kstken0210/ESP_Drone/esp32_drone_controller/esp32_drone_controller.kicad_pcb

## KiCad design esp32_drone_controller/esp32_drone_controller.kicad_pcb (2026-10-31)

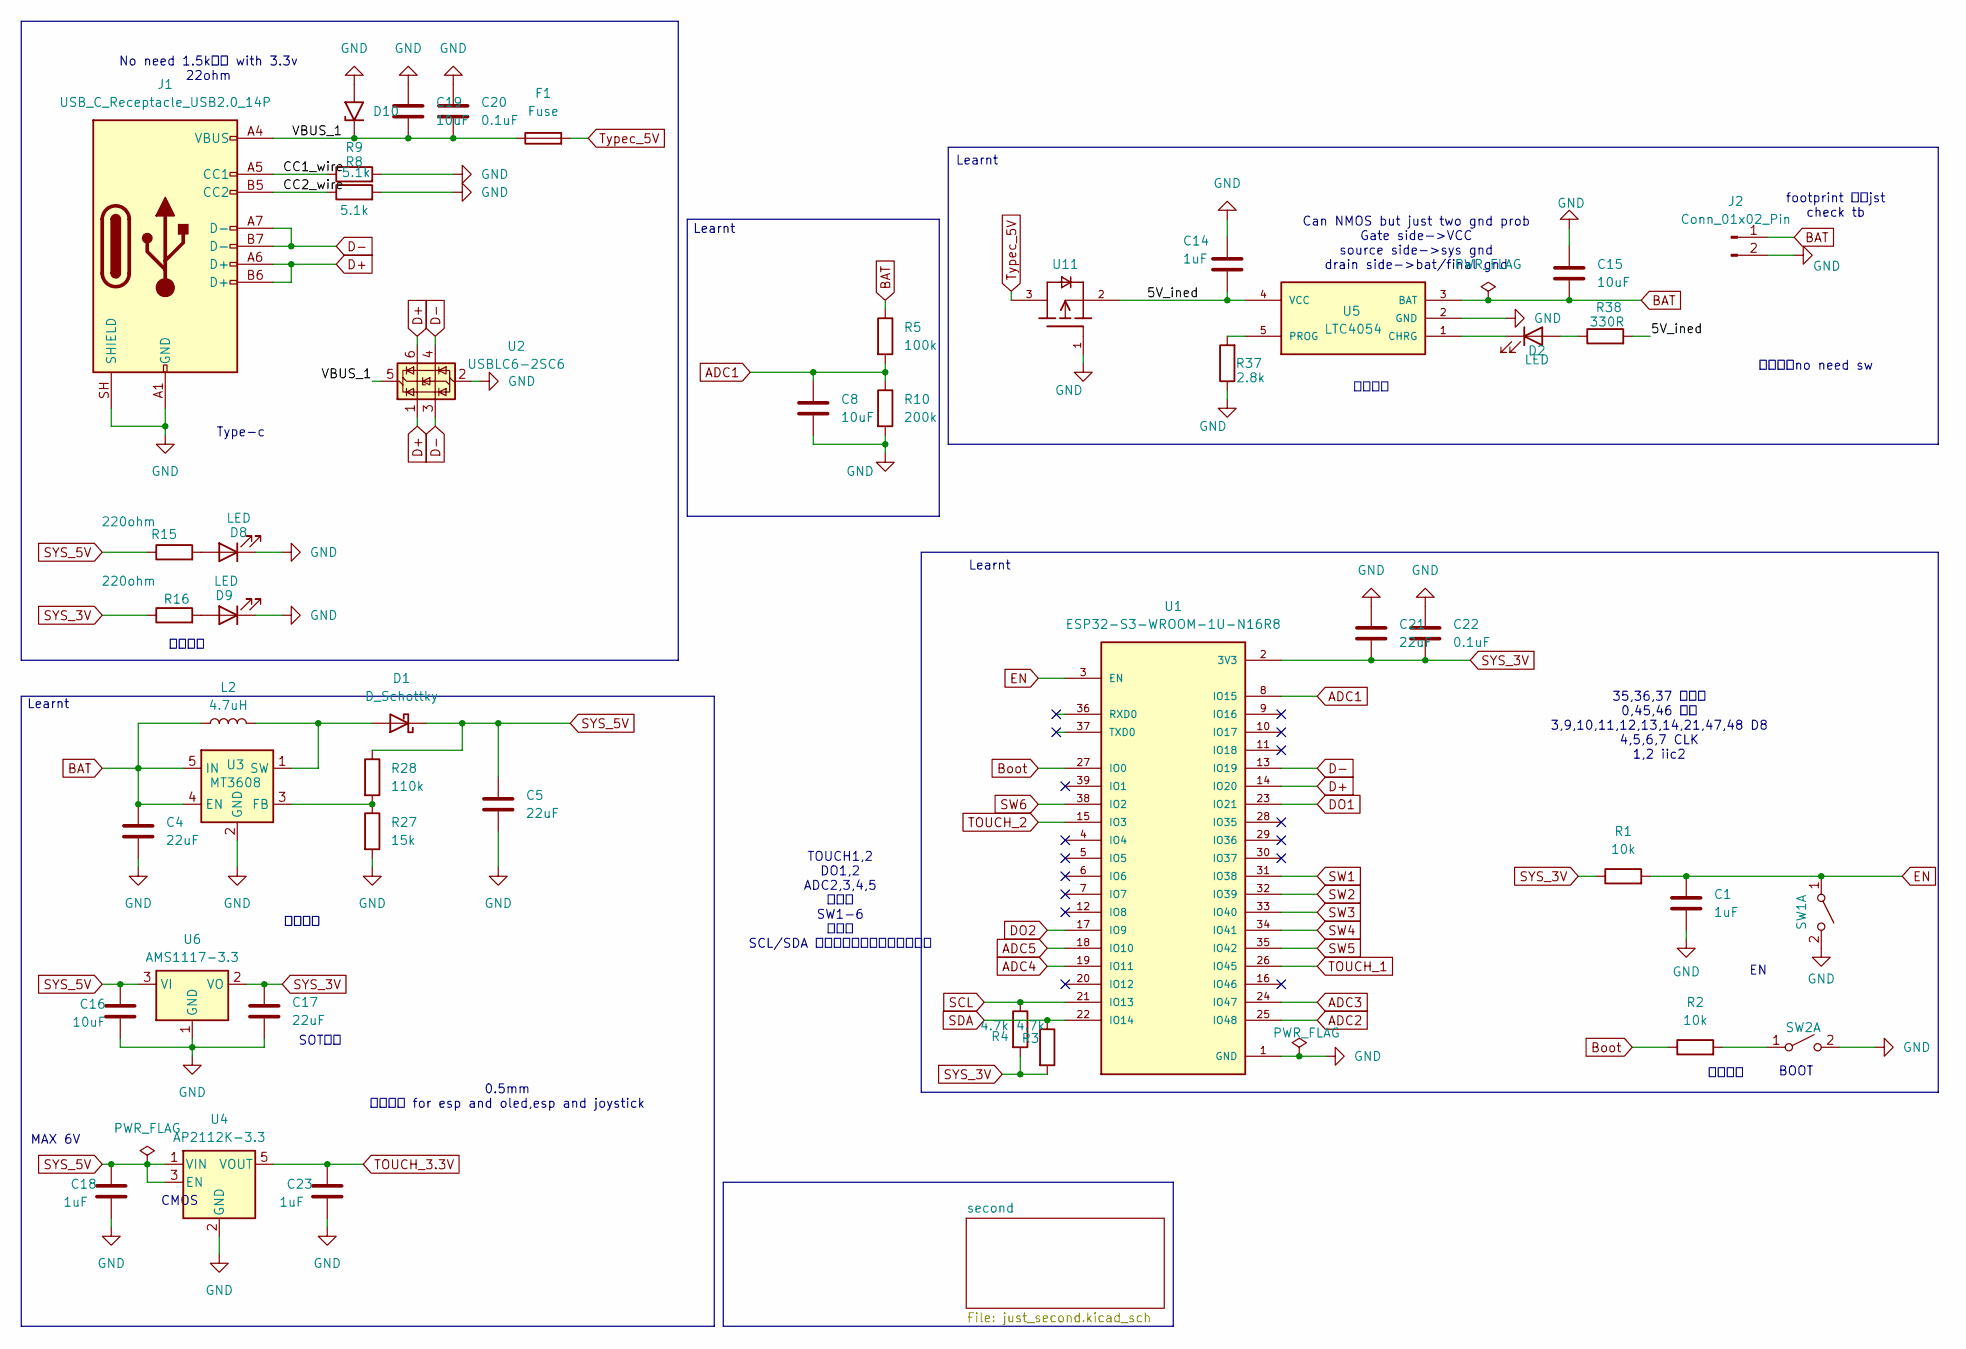
[picture p8: schematic esp32_drone_controller.kicad_sch]

Parts:
C1, C14, C18, C23: 1uF; C_0603_1608Metric_Pad1.08x0.95mm_HandSolder
C4, C5, C17, C21: 22uF; C_0603_1608Metric_Pad1.08x0.95mm_HandSolder
C8, C15, C16, C19: 10uF; C_0603_1608Metric_Pad1.08x0.95mm_HandSolder
C20, C22: 0.1uF; C_0603_1608Metric_Pad1.08x0.95mm_HandSolder
D1: D_Schottky; D_SOD-123
D2, D8, D9: LED; LED_0603_1608Metric_Pad1.05x0.95mm_HandSolder
D10: SMAJ5.0A; D_SOD-123F
F1: Fuse; Fuse_1206_3216Metric
J1: USB_C_Receptacle_USB2.0_14P; USB_C_Receptacle_GCT_USB4105-xx-A_16P_TopMnt_Horizontal
J2: Conn_01x02_Pin; Molex_PicoBlade_53047-0210_1x02_P1.25mm_Vertical
L2: 4.7uH; L_Sunlord_SWPA6045S
R1, R2: 10k; R_0603_1608Metric_Pad0.98x0.95mm_HandSolder
R3, R4: 4.7k; R_0603_1608Metric_Pad0.98x0.95mm_HandSolder
R5: 100k; R_0603_1608Metric_Pad0.98x0.95mm_HandSolder
R8, R9: 5.1k; R_0603_1608Metric_Pad0.98x0.95mm_HandSolder
R10: 200k; R_0603_1608Metric_Pad0.98x0.95mm_HandSolder
R15, R16: 220ohm; R_0603_1608Metric_Pad0.98x0.95mm_HandSolder
R27: 15k; R_0603_1608Metric_Pad0.98x0.95mm_HandSolder
R28: 110k; R_0603_1608Metric_Pad0.98x0.95mm_HandSolder
R37: 2.8k; R_0603_1608Metric_Pad0.98x0.95mm_HandSolder
R38: 330R; R_0603_1608Metric_Pad0.98x0.95mm_HandSolder
SW1, SW2: SW_DPST_x2; SW_SPST_TS-1088-xR025
U1: ESP32-S3-WROOM-1U-N16R8; XCVR_ESP32-S3-WROOM-1U-N16R8; PARTREV v1.1
U2: USBLC6-2SC6; SOT-23-6
U3: MT3608; SOT-23-6
U4: AP2112K-3.3; SOT-23-5
U5: LTC4054; SOT23-5L
U6: AMS1117-3.3; SOT-223-3_TabPin2
U11: AO3404; SOT23-3

Connections:
/5V_ined: C14.2, R38.2, U5.4 (VCC), U11.2
/CC1_wire: J1.A5 (CC1), R8.1
/CC2_wire: J1.B5 (CC2), R9.1
/VBUS_1: C19.2, C20.2, D10.1 (A1), F1.1, J1.A4 (VBUS), J1.A9 (VBUS), J1.B4 (VBUS), J1.B9 (VBUS), U2.5 (VBUS)
ADC1: C8.1, R5.2, R10.1, U1.8 (IO15)
ADC2: U1.25 (IO48); also elsewhere on the board
ADC3: U1.24 (IO47); also elsewhere on the board
ADC4: U1.19 (IO11); also elsewhere on the board
ADC5: U1.18 (IO10); also elsewhere on the board
BAT: C4.1, C15.2, J2.1, L2.1, R5.1, U3.4 (EN), U3.5 (IN), U5.3 (BAT)
Boot: R2.1, U1.27 (IO0)
D+: J1.A6 (D+), J1.B6 (D+), U1.14 (IO20), U2.1 (I/O1), U2.6 (I/O1)
D-: J1.A7 (D-), J1.B7 (D-), U1.13 (IO19), U2.3 (I/O2), U2.4 (I/O2)
DO1: U1.23 (IO21); also elsewhere on the board
DO2: U1.17 (IO9); also elsewhere on the board
EN: C1.2, R1.2, SW1.1 (A), U1.3 (EN)
GND: C1.1, C4.2, C5.2, C8.2, C14.1, C15.1, C16.2, C17.2, C18.2, C19.1, C20.1, C21.1, C22.1, C23.2, D8.1 (K), D9.1 (K), D10.2 (A2), J1.A1 (GND), J1.A12 (GND), J1.B1 (GND), J1.B12 (GND), J1.SH (SHIELD), J2.2, R8.2, R9.2, R10.2, R27.2, R37.1, SW1.2 (B), SW2.2 (B), U1.1 (GND), U1.40 (GND), U1.41_1 (GND), U1.41_2 (GND), U1.41_3 (GND), U1.41_4 (GND), U1.41_5 (GND), U1.41_6 (GND), U1.41_7 (GND), U1.41_8 (GND), U1.41_9 (GND), U2.2 (GND), U3.2 (GND), U4.2 (GND), U5.2 (GND), U6.1 (GND), U11.1; also elsewhere on the board
unnamed: D1.2 (A), L2.2, U3.1 (SW)
unnamed: D2.2 (A), R38.1
unnamed: D2.1 (K), U5.1 (CHRG)
unnamed: D8.2 (A), R15.2
unnamed: D9.2 (A), R16.2
unnamed: R2.2, SW2.1 (A)
unnamed: R27.1, R28.2, U3.3 (FB)
unnamed: R37.2, U5.5 (PROG)
SCL: R4.1, U1.21 (IO13); also elsewhere on the board
SDA: R3.1, U1.22 (IO14); also elsewhere on the board
SW1: U1.31 (IO38); also elsewhere on the board
SW2: U1.32 (IO39); also elsewhere on the board
SW3: U1.33 (IO40); also elsewhere on the board
SW4: U1.34 (IO41); also elsewhere on the board
SW5: U1.35 (IO42); also elsewhere on the board
SW6: U1.38 (IO2); also elsewhere on the board
SYS_3V: C17.1, C21.2, C22.2, R1.1, R3.2, R4.2, R16.1, U1.2 (3V3), U6.2 (VO); also elsewhere on the board
SYS_5V: C5.1, C16.1, C18.1, D1.1 (K), R15.1, R28.1, U4.1 (VIN), U4.3 (EN), U6.3 (VI); also elsewhere on the board
TOUCH_1: U1.26 (IO45); also elsewhere on the board
TOUCH_2: U1.15 (IO3); also elsewhere on the board
TOUCH_3.3V: C23.1, U4.5 (VOUT); also elsewhere on the board
Typec_5V: F1.2, U11.3

Notes on the sheet:
TOUCH1,2 DO1,2 ADC2,3,4,5 放下面 SW1-6 放右邊 SCL/SDA 可以放下就下，不行就右邊下
No need 1.5k上拉 with 3.3v 22ohm
SOT封裝
Learnt
35,36,37 不能用 0,45,46 慎用 3,9,10,11,12,13,14,21,47,48 D8 4,5,6,7 CLK 1,2 iic2
BOOT
有電會充no need sw
Type-c
默認上拉
0.5mm 星型接地 for esp and oled,esp and joystick
footprint 可能jst check tb
升壓電路
Can NMOS but just two gnd prob Gate side->VCC source side->sys gnd drain side->bat/final gnd
充電電路
CMOS
狀態檢測
MAX 6V

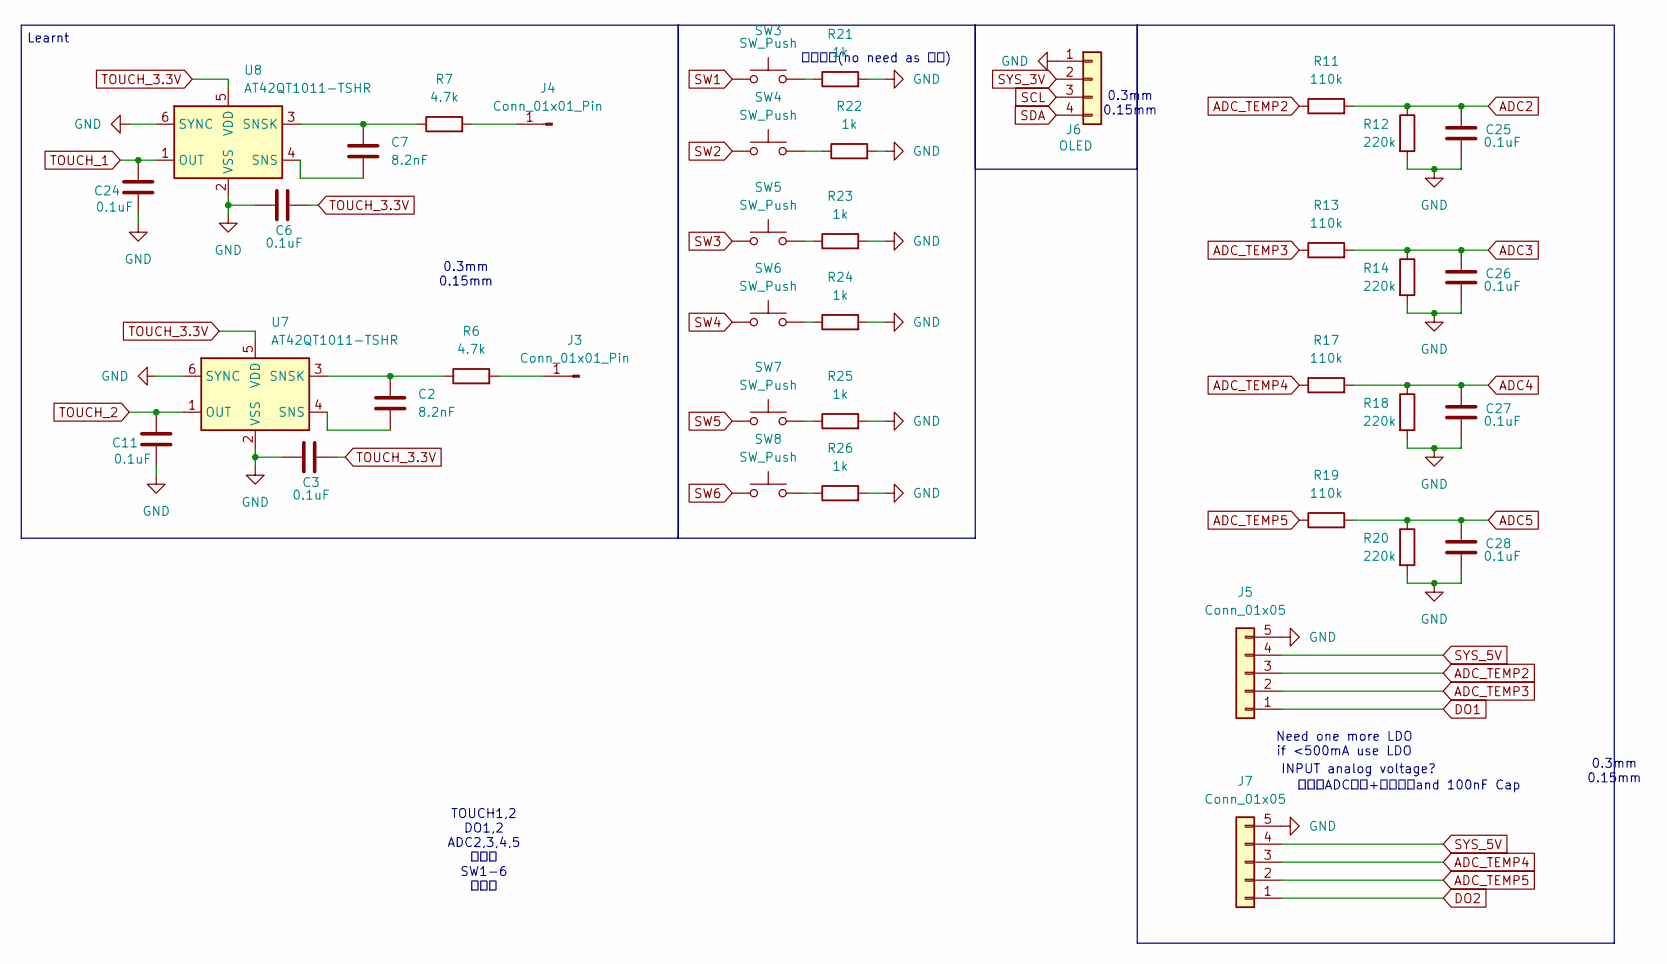
[picture p9: schematic just_second.kicad_sch]

Parts:
C2, C7: 8.2nF; C_0603_1608Metric_Pad1.08x0.95mm_HandSolder
C3, C6, C11, C24, C25, C26, C27, C28: 0.1uF; C_0603_1608Metric_Pad1.08x0.95mm_HandSolder
J3, J4: Conn_01x01_Pin; touch_pad_10mm_circle
J5, J7: Conn_01x05; PinSocket_1x05_P2.54mm_Horizontal
J6: OLED; PinSocket_1x04_P2.54mm_Vertical
R6, R7: 4.7k; R_0603_1608Metric_Pad0.98x0.95mm_HandSolder
R11, R13, R17, R19: 110k; R_0603_1608Metric_Pad0.98x0.95mm_HandSolder
R12, R14, R18, R20: 220k; R_0603_1608Metric_Pad0.98x0.95mm_HandSolder
R21, R22, R23, R24, R25, R26: 1k; R_0603_1608Metric_Pad0.98x0.95mm_HandSolder
SW3, SW4, SW5, SW6, SW7, SW8: SW_Push; SW_PUSH_6mm
U7, U8: AT42QT1011-TSHR; SOT-23-6

Connections:
ADC2: C25.1, R11.2, R12.1; also elsewhere on the board
ADC3: C26.1, R13.2, R14.1; also elsewhere on the board
ADC4: C27.1, R17.2, R18.1; also elsewhere on the board
ADC5: C28.1, R19.2, R20.1; also elsewhere on the board
ADC_TEMP2: J5.3, R11.1
ADC_TEMP3: J5.2, R13.1
ADC_TEMP4: J7.3, R17.1
ADC_TEMP5: J7.2, R19.1
DO1: J5.1; also elsewhere on the board
DO2: J7.1; also elsewhere on the board
GND: C3.1, C6.1, C11.2, C24.2, C25.2, C26.2, C27.2, C28.2, J5.5, J6.1, J7.5, R12.2, R14.2, R18.2, R20.2, R21.2, R22.2, R23.2, R24.2, R25.2, R26.2, U7.2 (VSS), U7.6 (SYNC), U8.2 (VSS), U8.6 (SYNC); also elsewhere on the board
unnamed: J3.1 (Pin_1_1), R6.2
unnamed: J4.1 (Pin_1_1), R7.2
unnamed: R21.1, SW3.2
unnamed: R22.1, SW4.2
unnamed: R23.1, SW5.2
unnamed: R24.1, SW6.2
unnamed: R25.1, SW7.2
unnamed: R26.1, SW8.2
unnamed: C2.1, U7.4 (SNS)
unnamed: C2.2, R6.1, U7.3 (SNSK)
unnamed: C7.1, U8.4 (SNS)
unnamed: C7.2, R7.1, U8.3 (SNSK)
SCL: J6.3; also elsewhere on the board
SDA: J6.4; also elsewhere on the board
SW1: SW3.1; also elsewhere on the board
SW2: SW4.1; also elsewhere on the board
SW3: SW5.1; also elsewhere on the board
SW4: SW6.1; also elsewhere on the board
SW5: SW7.1; also elsewhere on the board
SW6: SW8.1; also elsewhere on the board
SYS_3V: J6.2; also elsewhere on the board
SYS_5V: J5.4, J7.4; also elsewhere on the board
TOUCH_1: C24.1, U8.1 (OUT); also elsewhere on the board
TOUCH_2: C11.1, U7.1 (OUT); also elsewhere on the board
TOUCH_3.3V: C3.2, C6.2, U7.5 (VDD), U8.5 (VDD); also elsewhere on the board

Notes on the sheet:
TOUCH1,2 DO1,2 ADC2,3,4,5 放下面 SW1-6 放右邊
上拉輸入(no need as 自帶)
0.3mm 0.15mm
Learnt
每一個ADC都要+分壓電阻and 100nF Cap
INPUT analog voltage?
Need one more LDO if <500mA use LDO
