kstken0210/ESP_Drone/esp32_drone_controller/esp32_drone_controller.kicad_pcb

## KiCad design esp32_drone_controller/esp32_drone_controller.kicad_pcb (continued)

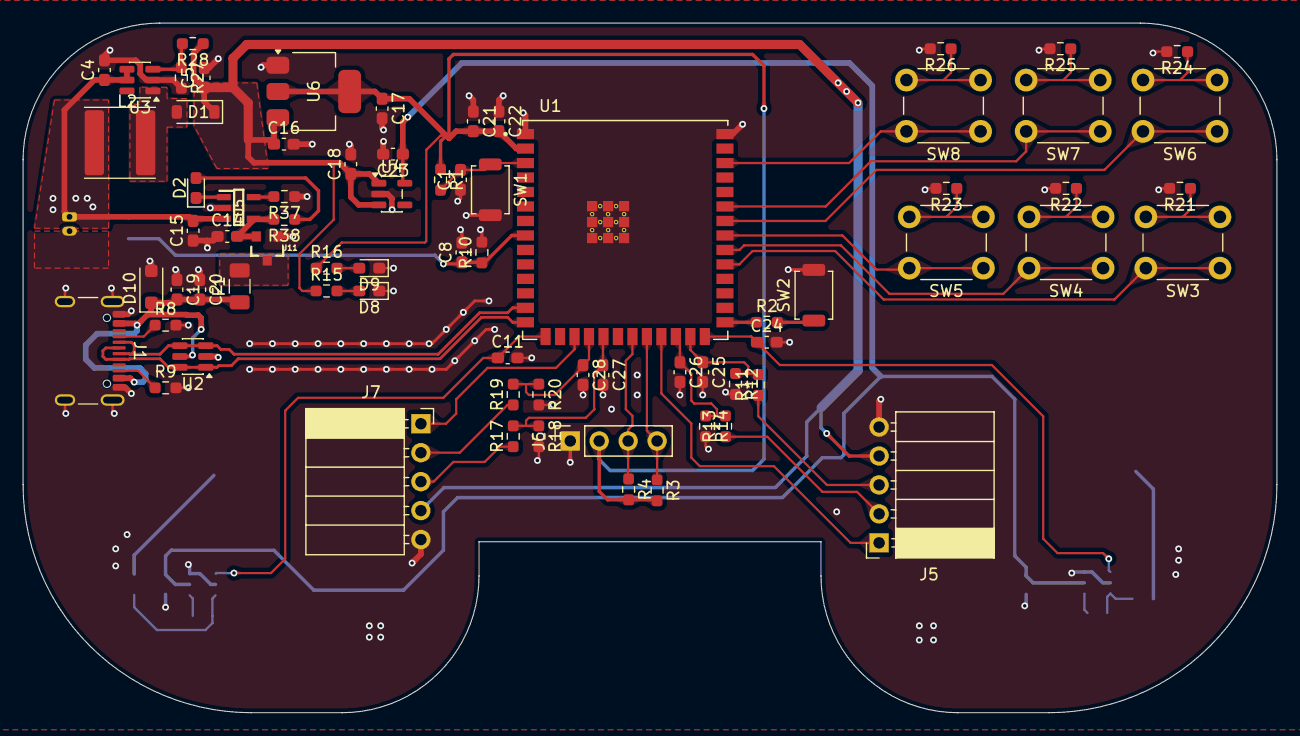
[picture p10: board esp32_drone_controller.kicad_pcb from above]

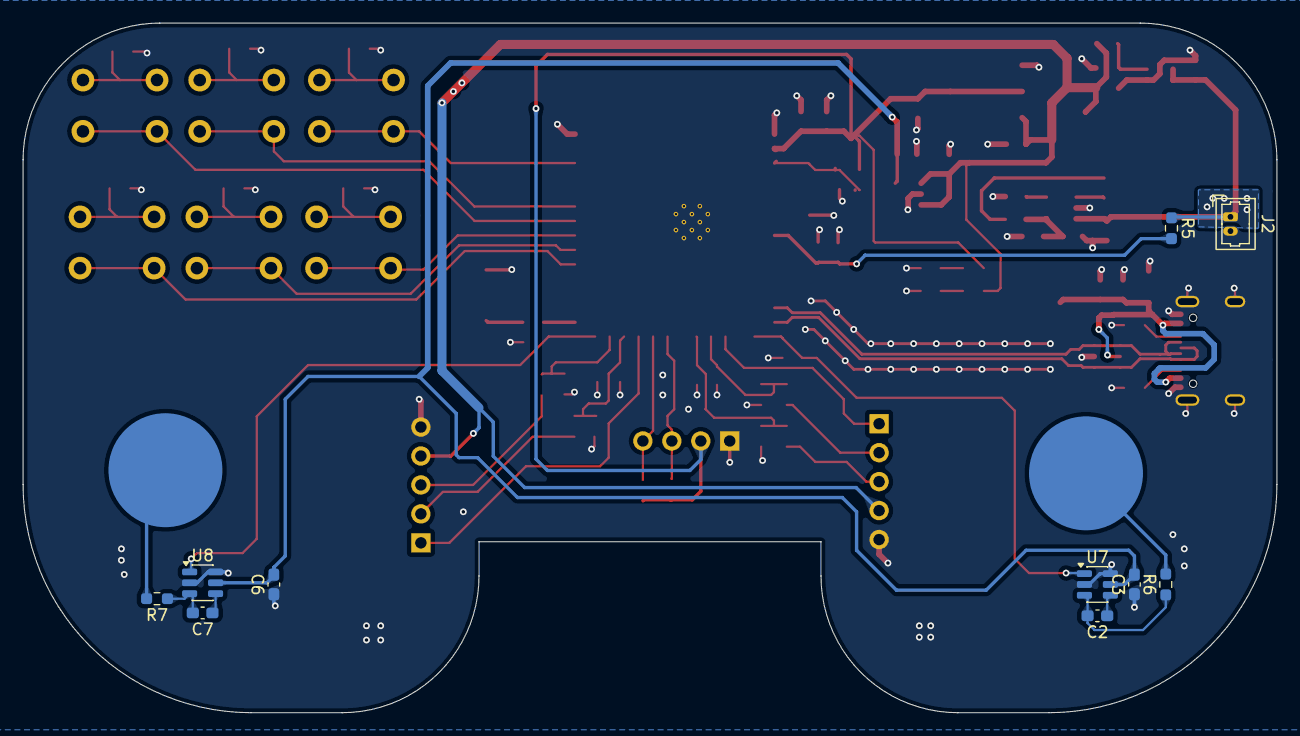
[picture p11: board esp32_drone_controller.kicad_pcb from below]

Board: 2 copper layers, 110.0 x 60.5 mm, 85 parts (12 on the bottom side), 55 nets.
